Aadak9/TSEA56-Lagerrobot/readme.md

Använd respektive underkatalog för inlämning av olika dokument i projektet.

Underkatalogen statusrapport innehåller en fil statusrapport.md som ska uppdateras vid varje rapportering enligt instruktioner i filen.
