Aadak9/TSEA56-Lagerrobot/projektplan/Projektplan_vers1.2.pdf

Lagerrobot | 2025-03-09

# Projektplan

Grupp 6

2025-03-09

Version 1.2

Status

Granskad | Ebba Lundberg | 2025-03-09
Godkänd | Namn | 2025-xx-xx
TSEA56 | Kandidatprojekt i elektronik
Projektplan

Grupp 6

Lagerrobot | 2025-03-09

Beställare:
Mattias Krysander, Linköpings universitet Telefon: +46 13282198
E-post: mattias.krysander@liu.se

Handledare:
Theodor Lindberg, Linköpings universitet E-post: theodor.lindberg@liu.se

## Projektdeltagare

Namn | Ansvar | E-post
Linus Funquist | | linfu930@student.liu.se
Ebba Lundberg | Dokumentansvarig | ebblu474@student.liu.se
Andreas Nordström | Projektledare | andno773@student.liu.se
Sigge Rystedt | | sigry751@student.liu.se
Ida Sonesson | Dokumentansvarig | idaso956@student.liu.se
Lisa Ståhl | Designansvarig | lisst342@student.liu.se
TSEA56 | Kandidatprojekt i elektronik
Projektplan

Grupp 6

Lagerrobot | 2025-03-09

### I N N E H Å L L

1 Beställare | 1
2 Översiktlig beskrivning av projektet | 1
3 Organisationsplan för hela projektet | 1
4 Dokumentplan | 2
5 Utvecklingsmetodik | 2
6 Utbildningsplan | 2
7 Rapporteringsplan | 2
8 Mötesplan | 3
9 Resursplan | 3
10 Milstolpar och beslutspunkter | 4
11 Aktiviteter | 5
12 Tidplan | 5
13 Prioriteringar | 5
14 Projektavslut | 6
Referenser | 7
15 Appendix | 8
A | Tidplan | 8
TSEA56 | Kandidatprojekt i elektronik
Projektplan

Grupp 6

Lagerrobot | 2025-03-09

### D O K U M E N T H I S TO R I K

Version | Datum | Utförda ändringar | Utförda av | Granskad
0.1 | 2025-02-12 | Första utkast | EL, LS, IS, LF, SR, AN | EL, SR, LS, AN
1.0 | 2025-02-24 | Första version | EL, LS, IS, LF, SR, AN | AN
1.1 | 2025-03-03 | Första version med ändringar | EL, IS | EL
1.2 | 2025-03-09 | Första version med uppdate-
| | rad tidsplan | EL | EL
TSEA56 | Kandidatprojekt i elektronik
Projektplan

Grupp 6

Lagerrobot | 2025-03-09

### 1 B E S TÄ L L A R E

Beställare av projektet är Mattias Krysander på ISY, LiU.

### 2 ÖV E R S I K T L I G B E S K R I V N I N G AV P R O J E K T E T

Systemet ska designas så att en robot både kan styras manuellt via en dator och autonomt. Lagermiljön, som roboten ska kunna navigera, är känd för systemet och består av ett rutnät med hinder, plockstationer och en väg till utlämningsstationen. Roboten ska kunna börja vid utlämningsstationen, autonomt följa en linje till lagret med hjälp av sensorer och kunna hitta tillbaka med upplockade varor. I själva lagret ska den kunna undvika hinder och navigera till plockstationer där varorna ligger.

### 2.1 Syfte och mål

Projektets syfte är att konstruera ett system som konstruktionsalternativ till en lagerrobot, som med snabbhet och repeterbarhet kan utföra sitt uppdrag. Lagerroboten är en prototyp till en robot som ska tillverkas. Denna kommer prövas i en tävling för att utvärdera hur väl målen kring snabbhet och repeterbarhet är uppfyllda.

### 2.2 Leveranser

Leveranser och deras datum specificeras i kravspecifikationen sektion 11 [2].

### 2.3 Begränsningar

När lagermiljön och plockstationer är definierade i persondatorn och autonomt läge start, ska roboten klara sig själv. Undantaget är om robotarmen ska styras manuellt, vilket sker från persondatorn. Material som kan användas är endast det som ISY tillhandahåller. Projektgruppen har ett begränsat antal timmar att tillhandahålla, se avsnitt ekonomi.

### 3 O R G A N I S AT I O N S P L A N F Ö R H E L A P R O J E K T E T

Organisationsplanen kommer i huvudsak att följa LIPS-modellen som beskrivs i Projektmodellen LIPS [1]. Den följer en v-modell bestående av: krav, planering, design, implementation och test & verifiering med regelbunden återkoppling mellan stegen. Syftet är att hitta problem innan projektet har gått för långt och korrigeringar blir alltför tidskrävande.

### 3.1 Villkor för samarbetet inom projektgruppen

Se gruppkontrakt [3].

TSEA56 | Kandidatprojekt i elektronik
Projektplan | 1

Grupp 6

Lagerrobot | 2025-03-09

### 3.2 Definition av arbetsinnehåll och ansvar

Roll | Namn | Beskrivning
Styrenhetsansvarig | Linus Funquist | Delansvarig över styrenheten
Dokumentansvarig, kommuniaktionsansvarig | Ebba Lundberg | Övergripande ansvar för samtliga dokument samt kommunikationsenheten
Projektledare, Sensoransvarig | Andreas Nordström | Övergripande ansvar över projektet och delansvarig över sensorenheten
Sensoransvarig | Sigge Rystedt | Delansvarig över sensorenheten
Dokumentansvarig, kommunikationsansvarig | Ida Sonesson | Övergripande ansvar för samtliga dokument samt kommunikationsenheten
Styrenhetsansvarig, designansvarig | Lisa Ståhl | Delansvarig över styrenheten och systemdesign

### 4 D O K U M E N T P L A N

Se kravspecifikationen sektion 12 [2].

### 5 U T V E C K L I N G S M E TO D I K

För att säkerställa ett effektivt arbetsflöde kommer arbetet att delas upp baserat på expertis. Uppdelningen grundar sig bland annat på förstudier. När en uppgift är slutförd kommer den frigjorda tiden att användas för att stödja övriga gruppmedlemmar i deras arbete.

### 6 U T B I L D N I N G S P L A N

För att kunna genomföra projektet kommer det under projektets gång att behöva genomföras utbildningar i form av föreläsningar, laborationer, seminarier samt förstudier.

### 6.1 Egen utbildning

Den egna utbildningen kommer främst riktas mot kunskaper inom områden såsom reglerteknik, sensor och kommunikation för att möjliggöra förstudierna.

### 7 R A P P O R T E R I N G S P L A N

En veckorapport ska skickas in till beställare varje vecka. Denna inkluderar en tidsrapport och en statusrapport som besvarar följande frågor: - Vilka framsteg har gjorts sedan förra tidrapporten? - Finns det några problem? - Vad ska göras under den kommande veckan?
Veckorapporten ska skrivas av samtliga i gruppen under ett planerat möte varje måndag.
TSEA56 | Kandidatprojekt i elektronik
Projektplan | 2

Grupp 6

Lagerrobot | 2025-03-09

### 8 M ÖT E S P L A N

Under projektets gång kommer regelbundna möten genomföras en gång i veckan, med målet att gå igenom förra veckans arbete samt planera nästa vecka.

### 9 R E S U R S P L A N

Nedanstående punkter beskriver vilka olika typer av resurser gruppen har att tillgå.

### 9.1 Personer

Arbete förväntas av samtliga i gruppen utöver röda dagar, tentaperioder och planerade ledigheter. Planerad ledighet bör förvarnas om i god tid och berörd gruppmedlem bör kompensera denna frånvaro enligt överenskommelse inom gruppen.

### 9.2 Material

Materialet som kommer att användas tillgodoses av ISY och innefattar robotplattform, robotarm, mikrodatorer, sensorer, batterier samt motorer för reglering.

### 9.3 Lokaler

Projektgruppen kommer att ha tillgång till en laborationssal i Muxen samt Visionen där tester kommer att utföras.

### 9.4 Ekonomi

Gruppen har 230 timmar per person, totalt 1380 timmar för att lösa uppgiften. Dessa börjar räknas efter BP3.

TSEA56 | Kandidatprojekt i elektronik
Projektplan | 3

Grupp 6

Lagerrobot | 2025-03-09

### 10 M I L S TO L PA R O C H B E S L U T S P U N K T E R

Följande underrubriker beskriver projektets milstolpar och beslutspunkter samt när dessa infaller.

### 10.1 Milstolpar

Tabellen nedan visar samtliga milstolpar i projektet samt datumet då de infaller.

Nr | Beskrivning | Datum
0 | Designspecifikation 1.0 inlämnad | 12/3
1 | Förstudie inlämnad | 7/4
2 | Bussen klar | 10/4
3 | Manuell styrning | 25/4
4 | Manuell styrning av robotarm | 2/5
5 | Roboten kan följa tejpbit | 6/5
6 | Autonom körning | 13/5
7 | Fullständig GUI | 19/5
8 | Färdig presentation | 30/5
9 | Färdig rapport | 6/6

### 10.2 Beslutspunkter

Tabellen nedan visar samtliga beslutspunkter i projektet samt datumet då de infaller.

Nr | Beskrivning | Datum
0 | Projektgruppen formad och projektgrupp tilldelad | 24/1
1 | Kravspecifikationen v1.0 ska vara klar | 6/2
2 | Efter godkänd projektplan, tidplan och systemskiss hålls BP2 mötet med beställaren. | 24/2
3 | Designspecifikation godkänd | 12/3
4 | Nuvarande design godkänd av handledare | 17/4
5a | Färdigställandet av baskrav verifieras | 7/5
5b | Färdigställandet av slutkrav verifieras | 21/5
6 | Projektet avslutas | 9/6
TSEA56 | Kandidatprojekt i elektronik
Projektplan | 4

Grupp 6

Lagerrobot | 2025-03-09

### 11 A K T I V I T E T E R

Tabellen nedan visar samtliga aktiviteter i projektet, uppskattad tid och beroenden till andra aktiviteter.

Nr | Aktivitet | Beroende av aktivitet nr | Beräknad tid
1 | Skriva designspecifikation | | 80
2 | Kommunikation mellan PC och kommunikationsenheten | | 10
3 | Konstruera en fungerande buss mellan delsystemen | | 90
4 | Seriell överföring av data mellan PC och styrmodul | 2, 3 | 35
5 | Seriell överföring av data från sensormodul till PC | 2, 3, 7 | 30
6 | Fungerande kortaste väg algoritm med hinder | | 35
7 | Få alla sensorer att kunna läsa data | | 40
8 | Skriv kod för sensormodulen som gör om sensordata till läsbara storheter | | 60
9 | Spara sensordata på PC | 5 | 20
10 | Installera sensorenhet på robotplattform | | 20
11 | Få reflexsensorerna att registrera en tejpbit och lagerroboten kan stanna via en avbrottsrutin | 4, 5, 14 | 80
12 | Styrenheten kan skicka kommandon till styrmotorerna | | 40
13 | Skapa GUI som möjliggör testning | | 40
14 | Få robotplattformen att röra sig genom manuell styrning från PC | 4, 13, 18 | 60
15 | Kunna styra robotarmen manuellt | 4, 13 | 120
16 | Kunna plocka upp vara med robotarmen via fjärrstyrning | 15 | 60
17 | Skapa fullständig GUI för PC | 4, 9, 13 | 60
18 | Installera styr- och kommunikationsenhet på robotplattformen | | 50
19 | Få roboten att röra sig genom autonom styrning | 14 | 80
20 | Roboten kan åka till och från hämtningsstationen | 11, 19 | 70
21 | Skriva användarhandledning | | 30
22 | Skriva presentation | | 20
23 | Skriva efterstudie | | 15
24 | Skriva kappa | | 20
25 | Skriva teknisk dokumentation | | 60

### 12 T I D P L A N

Se Appendix A.

### 13 P R I O R I T E R I N G A R

Prioriteringar på projektet kommer att följa det som beskrevs i kravspecifikationen. Prioritet 1 krav kommer göras först följt av 2 och i mån av tid 3. Om nödvändigt kommer förseningar diskuteras med beställaren för omförhandling av kravspecifikationen.

TSEA56 | Kandidatprojekt i elektronik
Projektplan | 5

Grupp 6

Lagerrobot | 2025-03-09

### 14 P R O J E K TAV S L U T

Projektet avslutas den 9:e juni. Då ska:

- Efterstudien vara inlämnad
- Komplett och väldokumenterad källkod vara incheckad på git
- Komplett kandidatrapport vara inlämnad som en pdf-fil med all appendix inkluderade
- All utrustning och nycklar vara återlämnade
TSEA56 | Kandidatprojekt i elektronik
Projektplan | 6

Grupp 6

Lagerrobot | 2025-03-09

### R E F E R E N S E R

[1] Projektmodellen LIPS (2011), Tomas Svensson och Christian Krysander, uppl. 1:1, Studentlitteratur AB, Lund, ISBN 978-91-44-07525-9
[2] Kravspecifikation (2025), Grupp6: Kravspec_grupp6_version1.0.pdf
[3] Gruppkontrakt (2025), Grupp6: Gruppkontrakt_grupp6.pdf
TSEA56 | Kandidatprojekt i elektronik
Projektplan | 7

Grupp 6

Lagerrobot | 2025-03-09

### 15 A P P E N D I X

A | T I D P L A N
TSEA56 | Kandidatprojekt i elektronik
Projektplan | 8

Grupp 6

AKTIVITETER | TID | VEM | TIDPLAN (när), veckonummer
Nr | Beskrivning | timmar | Initialer | 1 | 2 | 3 | 4 | 5 | 6 | 7 | 8 | 9 | 10 | 11 | 12 | 13 | 14 | 15 | 16 | 17 | 18 | 19 | 20 | 21 | 22 | 23
| Kravspecifikation
| Tidsplan
| Gruppkontrakt
| Systemskiss
| Skrivuppgift
| Projektplan
72 | Alla | T | P | T | 0
el | E | Å | E | 0
N | S | N | 0
T | K | T | 0
240 | A | A | 0
P | P | 0

0
1 | 80 | Alla | 10 | 30 | 30 | 10 | 80

0
2 | 10 | el, is | 10 | 10
3 | 90 | el, is | 60 | 30 | 90
4 | 35 | el, is, ls, lf | 35 | 35
5 | 30 | el, is, an, sr | 30 | 30
6 | 35 | Alla | 35 | 35

0
7 | Få alla sensorer att kunna läsa data | 40 | an, sr | 40 | 40
8 | Skriv kod för sensormodulen som gör om sensordata till läsbara storheter | 60 | an, sr | 30 | 30 | 60
9 | Spara sensordata på PC | 20 | an, sr | 20 | 20
10 | Installera sensorenhet på robotplattform | 20 | an, sr | 20 | 20
11 | Få reflexsensorerna att registrera en tejpbit och lagerroboten kan stanna via en avbrottsrutin | 80 | an, sr | 60 | 20 | 80
Styrenhet | 0
12 | Styrenheten kan skicka kommandon till styrmotorerna | 40 | ls, lf | 40 | 40
PC | 0
13 | Skapa GUI som möjliggör testning | 40 | Alla | 10 | 30 | 40
14 | Få robotplattformen att röra sig genom manuell styrning från PC | 60 | Alla | 60 | 60
15 | Kunna styra robotarmen manuellt | 120 | Alla | 60 | 60 | 120
16 | Kunna plocka upp vara med robotarmen via fjärrstyrning | 60 | Alla | 40 | 20 | 60
17 | Skapa fullständig GUI för PC | 60 | Alla | 40 | 20 | 60

0
18 | Installera styr- och kommunikationsenhet på robotplattformen | 50 | Alla | 50 | 50
19 | Få roboten att röra sig genom autonom styrning | 80 | Alla | 80 | 80
20 | Roboten kan åka till och från hämtningsstationen | 70 | Alla | 40 | 30 | 70
Dokumentation | 0
21 | Användarhandledning | 30 | Alla | 20 | 10 | 30
22 | Presentation | 20 | Alla | 20 | 20
23 | Efterstudie | 15 | Alla | 15 | 15
24 | Kappa | 20 | Alla | 20 | 20
25 | Teknisk dokumentation | 60 | Alla | 10 | 50 | 60
Övrigt | 0
Buffert | 135 | 13 | 13 | 13 | 13 | 13 | 14 | 14 | 14 | 14 | 14 | 135
Projektmöten | 40 | Alla | 4 | 4 | 4 | 4 | 4 | 4 | 4 | 4 | 4 | 4 | 40
Milstolpar | 0
0 | Designspecifikation 1.0 inlämnad | on | 0
1 | Förstudie inlämnad | må | 0
2 | Bussen klar | to | 0
3 | Manuell styrning | fre | 0
4 | Manuell styrning av robotarm | fre | 0
5 | Roboten kan följa tejpbit | ti | 0
6 | Autonom körning | ti | 0
7 | Fullständig GUI | må | 0
8 | Färdig presentation | fr | 0
9 | Färdig rapport | fr | 0

0
0
Beslutspunkter | 0
BP 1 | to | 0
BP 2 | må | 0
BP 3 | on | 0
BP 4 | to | 0
BP 5a | on | 0
BP 5b | on | 0
BP 6 | må | 0

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
1380 | 0 | 0 | 0 | 0 | 0 | 0 | 0 | 10 | 30 | 30 | 10 | 0 | 10 | 227 | 212 | 37 | 177 | 157 | 198 | 133 | 133 | 18 | 18 | ###

Basplan
Projekt:
Datum:
Ebba Lundberg, 2025-03-09
Projektgrupp: | Granskad:
| Mattias Krysander
Kurs: | TSEA56

Summa antal timmar:

Beställare:

Designspecifikation
Kommunikationsenhet
Kommunikation mellan PC och kommunikationsenheten Konstruera en fungerande buss mellan delsystemen Seriell överföring av data mellan PC och styrmodul Seriell överföring av data från sensormodul till PC Fungerande kortaste väg algoritm med hinder Sensorenhet

3/9/2025
1.2
Ebba Lundberg

Version:
Utfärdare:

G06
