Aadak9/TSEA56-Lagerrobot/RaspberryPi/main2.py

import spi as spi
import bluetooth as bt
import autonom as auto
import time
import threading
from collections import deque
import handle_map as hm
import json
import fastest_way3 as fw

global next_move
next_move = None
global new_plan
new_plan = False
global goal_collected
goal_collected = False
global nodeorder
nodeorder = []
size = 1024

has_seen_roadmark = False
global obstacles
obstacles = []
global goods_deposited
goods_deposited = False

def autonomous_loop(spi_styr, spi_sensor, KP, KD):
	global nav_plan
	global new_plan
	global goal_collected
	global has_seen_roadmark
	global nodeorder
	global obstacles
	global goods_deposited
	try:
		next_move = nav_plan[0]
	except:
		return
	roadmark_status = auto.check_roadmark(spi_sensor)
	målnoder = hm.get_målnoder()

	
	if(auto.check_obstacle(spi_sensor)):
		spi.send_spi(spi_styr, 0) #stanna
        
		current_node, next_node = fw.find_location(nav_plan, nodeorder) #current_node = den noden man åker tillbaka till efter påkommet hinder, next_node = den man inte kom till 
		obstacles.append([current_node, next_node])
		målnoder[1] = [current_node]
		nav_plan, nodeorder = hm.update_path_obstacles(obstacles, målnoder) #måste komma åt målnoder på nåt sätt        
		new_plan = True
		auto.rotate_right_180(spi_styr, spi_sensor)
        
	if(roadmark_status == 0):
		has_seen_roadmark = False
		auto.control_loop(spi_styr, spi_sensor, KP, KD)
		
	elif(roadmark_status == 1): # dags att plocka vara åt höger
		if(next_move == "plocka"):
			goal_collected = True
			spi.send_spi(spi_styr, 0) #stanna och plocka vara
			auto.pick_right(spi_styr)
			current_node, next_node = fw.find_location(nav_plan, nodeorder) 
			hm.remove_goal_node(current_node, next_node)
			next_move = nav_plan.popleft()
			if(nav_plan[0] == "vänd"):
				auto.rotate_right_180(spi_styr, spi_sensor)
				nav_plan.popleft()
		else:
			auto.drive_fwd(spi_styr) # Kör förbi plockstaion
			
	elif(roadmark_status == 2): # dags att plocka vara åt vänster
		if(next_move == "plocka"):
			goal_collected = True 
			spi.send_spi(spi_styr, 0) #stanna och plocka vara
			auto.pick_left(spi_styr)
			current_node, next_node = fw.find_location(nav_plan, nodeorder) 
			hm.remove_goal_node(current_node, next_node)
			next_move = nav_plan.popleft()
			if(nav_plan[0] == "vänd"):
				auto.rotate_right_180(spi_styr, spi_sensor)
				nav_plan.popleft()
		else:
			auto.drive_fwd(spi_styr) # Kör förbi plockstaion
			
	elif(roadmark_status == 3 and not has_seen_roadmark): #sväng utifrån planerad väg
		has_seen_roadmark = True
		time.sleep(0.08)
		if(nav_plan):
			next_move = nav_plan.popleft()
		else:
			print("Slut på styrbeslut")
		#Kolla om vi ska svänga eller ej
        
		if(next_move == "rakt"):
			auto.drive_fwd(spi_styr)
		elif(next_move == "vänster"):
			auto.rotate_left(spi_styr, spi_sensor)  
		elif(next_move == "höger"):
			auto.rotate_right(spi_styr, spi_sensor)
		elif(next_move == "lämna"):
			spi.send_spi(spi_styr, 0)
			auto.empty_basket3(spi_styr)
			goods_deposited = True
			
	else:
		auto.drive_fwd(spi_styr)
       

def bluetooth_control_loop(data, client, spi_styr, spi_sensor):
	global new_plan
	global nav_plan
	global målnoder
	global goal_collected
	global goods_deposited
	try:
		if(data == "20"): #Ändrar aktuell armled
			data = client.recv(size) 
			try:
				spi.send_spi(spi_styr, [0x20] + list(data))
			except:
				print("Invalid data 1")
                
		elif data == "60": #IR
			response = spi.send_spi(spi_sensor, 0)
			client.send(response.to_bytes(1, 'big'))		
		elif data == "61": #Reflex
			response = spi.send_spi(spi_sensor, 1)
			client.send(response.to_bytes(1, 'big'))	
		elif data == "67": #kalibrera linjesensor
			spi.send_spi(spi_sensor, 7)
			time.sleep(0.01)
			
		elif data == "63": #Starta gyro
			spi.send_spi(spi_sensor, 3)
			time.sleep(0.01)
		elif data == "62": #Gyro
			response = spi.send_spi(spi_sensor, 5)
			client.send(response.to_bytes(1, 'big'))
		elif data == "64": #Stoppa gyro
			spi.send_spi(spi_sensor, 4)
			time.sleep(0.01)
			
		elif data == "65": #gaspådrag höger
			response = spi.send_spi(spi_styr, 0x41)
			client.send(response.to_bytes(1, 'big'))
		elif data == "66": #gaspådrag vänster
			response = spi.send_spi(spi_styr, 0x40)
			client.send(response.to_bytes(1, 'big'))
            
		elif data == "80": #skicka styrbeslut
			if new_plan:
				client.send(b'\x01')
				hm.send_map(nav_plan, client)
				new_plan = False
			else:
				client.send(b'\x00')
		elif data == "81": #upplockade varor
			if goal_collected:
				client.send(b'\x01')
				goal_collected = False
			else:
				client.send(b'\x00')
				
		elif data == "82": #avbryta autonomt läge i gui
			if goods_deposited:
				client.send(b'\x01')
				goods_deposited = False
			else:
				client.send(b'\x00')
        
		else:
			try:
				response = spi.send_spi(spi_styr, int(data, 16))	
			except:
				print("Invalid data 2")
	except:
		print("Disconnected, looking for new socket")            


def bluetooth_listener(s, spi_styr, spi_sensor):
	global new_plan
	global nav_plan
	global nodeorder
	global goods_deposited
	global obstacles
	client, _ = s.accept()
	print("Bluetooth connected")
	while True:
		try:
			data = client.recv(1).hex()
			if data == "99": #Växla körläge
				if auto.Automatic:
					spi.send_spi(spi_styr, 0)
				else:
					nav_plan, nodeorder = hm.update_path(client) #tagit bort att den ska ta emot nodeorder
					new_plan = True  
					goods_deposited = False
					obstacles = []
				auto.Automatic = not auto.Automatic
				continue
			else:
				bluetooth_control_loop(data, client, spi_styr, spi_sensor)
		except Exception as e:
			print(f"Bluetooth error: {e}")
			try:
				client.close()
			except:
				pass
			print("Waiting for connection...")
			client, _ = s.accept()
			print("Connected!")


def main():
	global nav_plan
	nav_plan = 0
	s = bt.init_bluetooth()
	spi_styr, spi_sensor = spi.initspi()

	bt_thread = threading.Thread(target=bluetooth_listener, args=(s, spi_styr, spi_sensor), daemon=True)
	bt_thread.start()

	KP, KD = 100, 100

	while True:
		old_Automatic = auto.Automatic
		if auto.Automatic:
			autonomous_loop(spi_styr, spi_sensor, KP, KD)
			time.sleep(0.005)
		if(old_Automatic == True and auto.Automatic == False):
			spi.send_spi(spi_styr, 0)
        

if __name__ == "__main__":
    main()
