Aadak9/TSEA56-Lagerrobot/Styr/Styrenhet/Styrenhet/Kommunikations_Definitioner.h

#define DRIVE_FWD 0x1

#define ROTATE_LEFT 0x2

#define REVERSE 0x3

#define ROTATE_RIGHT 0x4

#define FWD_LEFT 0x5

#define FWD_RIGHT 0x6

#define STOP 0

#define DECREASE_SPEED 0x14

#define INCREASE_SPEED 0x15

#define SET_JOINT 0x20

#define FOLLOW_LINE 0x30

#define CCW_SERVO 0x31

#define CW_servo 0x32

#define SEND_LEFT_GAS 0x40

#define SEND_RIGHT_GAS 0x41

#define SEND_ANGLE 0x50

#define MOVE_SERVO 0x60
