Aadak9/TSEA56-Lagerrobot/RaspberryPi/fastest_way3.py

from collections import deque
import itertools
#Får lagerbredd, lagerhöjd, koordinater för målnod från PC


def skapa_graf(lagerbredd, lagerhöjd):
	#skapar dictionary med alla grannar nedåt och till höger för alla noder i lagret
	graf = {}
	ny = lagerbredd + 1
	nx = lagerhöjd + 1
	for y in range(ny):
		for x in range(nx):
			node = y * nx + x + 1
			graf[node] = []
			# höger granne
			if x < nx - 1:
				graf[node].append(node + 1)
			# nedåt granne
			if y < ny - 1:
				graf[node].append(node + nx)
			# vänster granne
			if x > 0:
				graf[node].append(node - 1)
			# övre granne
			if y > 0:
				graf[node].append(node-nx)
	return graf


def bfs(graf, startnod, målnod, next_node, last_node):    
	# Beräknar korstaste vägen mellan två ndoer
	paths = [] 
	for i  in range(len(startnod)):
		queue = deque([[startnod[i]]])
		visited = set()
		while queue:
			path = queue.popleft()
			node = path[-1]
			if node in visited:
				continue
			visited.add(node)
			for neighbor in graf[node]:
				new_path = path + [neighbor]
				if [node, neighbor] == målnod or [neighbor, node] == målnod or [neighbor] == målnod:
					paths.append(new_path + ['goal'])
				queue.append(new_path)
	if last_node == 0:
		return min(paths, key=len)
	if len(målnod) == 1 and målnod[0] in startnod and last_node != 1: #om varan ligger jämte nod 1 och inte kommer från nod 1 ...
		for i in startnod:
			if [i] != målnod:
				return [målnod[0], 'goal'] #.... ska den åka ut
	
	shortest_dist = min(len(l) for l in paths)
	shortest_paths = [l for l in paths if len(l) == shortest_dist]
	check = False
	# Om två vägar är lika lång och en kräver vändning så välj den som inte vänder
	for i in range(len(shortest_paths)-1):
		if len(shortest_paths) > 1 and shortest_paths[i][0] != shortest_paths[i+1][0]:
			check = True
	if check:
		for j in shortest_paths[:]:
			if j[0] != next_node:
				shortest_paths.remove(j)
	shortest = min(shortest_paths, key=len)
	if shortest[0] != next_node:
		shortest = [next_node] + shortest
	
	return shortest

    
def skapa_avståndsmatris(graf, nodes):
	#Skapar avståndsmatris med längden mellan varje par noder
	ant_noder  = len(nodes) 
	matris = [[0]*ant_noder for _ in range(ant_noder)]
	for i in range(ant_noder):
		for j in range(ant_noder):
			if i != j:
				path = bfs(graf, nodes[i+1], nodes[j+1], 0, 0)
				if i == 0:
					matris[i][j] = len(path) - 2 if path else float('infinity')
				else:
					matris[i][j] = len(path) - 1 if path else float('infinity')

	return matris
 
 
def held_karp_väg(matris):
	# Beräknar kortaste vägen från start, genom alla målnoder och till slut samt kostnaden för den vägen
	n = len(matris)
	dp = [[float('inf')] * n for _ in range(1 << n)]
	parent = [[-1] * n for _ in range(1 << n)]
	dp[1][0] = 0  # Startar i nod 0

	for mask in range(1 << n):
		for u in range(n):
			if not (mask & (1 << u)):
				continue
			for v in range(n):
				if mask & (1 << v):
					continue
				next_mask = mask | (1 << v)
				new_cost = dp[mask][u] + matris[u][v]
				if new_cost < dp[next_mask][v]:
					dp[next_mask][v] = new_cost
					parent[next_mask][v] = u

	# Hitta bästa retur till start
	slutkostnad = float('inf')
	sista_nod = -1
	full_mask = (1 << n) - 1
	for i in range(1, n):
		cost = dp[full_mask][i] + matris[i][0]
		if cost < slutkostnad:
			slutkostnad = cost
			sista_nod = i

	# Återskapa vägen baklänges
	path = [0]
	mask = full_mask
	current = sista_nod
	while current != -1:
		path.append(current)
		prev = parent[mask][current]
		mask = mask ^ (1 << current)
		current = prev

	path = list(reversed(path))
	return slutkostnad, path


def node_to_xy(node, lagerbredd, lagerhöjd):
	#Tilldelar koordinater till noden
	nx = lagerbredd + 1
	ny = lagerhöjd + 1
	for i in range(0, nx):
		for j in range(0, ny):
			if node == j + ny * i + 1:
				return(i, j)
			else:
				continue
    
	return(0,0)
            

def get_direction(p1, p2):
	#Beräknar differans i koordinater mellan två noder
	return (p2[0] - p1[0], p2[1] - p1[1])


def direction_to_angle(direction):
	# Gör om (dx, dy) till en riktning i grader
	if direction == (0, 1):
		return 0    # nedåt
	elif direction == (1, 0):
		return 90   # höger
	elif direction == (0, -1):
		return 180  # uppåt
	elif direction == (-1, 0):
		return 270  # vänster
	else:
		return None # ogiltig


def sväng_instructions(correct_path, lagerbredd, lagerhöjd):
	# Omvanlar nodföljden till styrbeslut
	directions = []
	# Ta bort 'goal'
	pos = [node_to_xy(n, lagerbredd, lagerhöjd) for n in correct_path if isinstance(n, int)]
	if len(pos) < 2:
		return directions

	# Initial riktning. Kommer alltid "uppifrån" in i nod 1
	prev_angle = 0
    
	for i in range(0, len(correct_path)-1):
		
		if correct_path[i] == 'goal':
			directions.append("plocka")
		
		elif correct_path[i] != 'goal' and correct_path[i+1] != 'goal': 
			curr = node_to_xy(correct_path[i], lagerbredd, lagerhöjd)
			next_n = node_to_xy(correct_path[i+1], lagerbredd, lagerhöjd)
			current_dir = get_direction(curr, next_n)
			current_angle = direction_to_angle(current_dir)
			
			delta = (current_angle - prev_angle) % 360
			#print("delta " + str(delta))
			if delta == 0:
				directions.append("rakt")  # rakt fram
			elif delta == 90:
				directions.append("vänster")  # höger
			elif delta == 270:
				directions.append("höger")  # vänster
			elif delta == 180:
				directions.append("vänd")  # vändning
			else:
				directions.append("vänd")  # vändning

			prev_angle = current_angle
    
	if current_angle == 270:
		directions.append("höger")
	elif current_angle == 180:
		directions.append("rakt")

	return directions


def remove_path(Graf, n1, n2):
	#Ta bort n1 från n2´s grannar och n2 från n1´s grannar
	for i in Graf:
		if i == n1:
			Graf[i].remove(n2)
		elif i == n2:
			Graf[i].remove(n1)
    
	return(Graf)
            

def fastest_way(lagerbredd, lagerhöjd, målnoder):
	#Beräknar kortaste vägen
	Graf = skapa_graf(lagerbredd, lagerhöjd)
	matris = skapa_avståndsmatris(Graf, målnoder)
	kostnad, ordning = held_karp_väg(matris)
	key = list(målnoder)[-1]
	if målnoder[key] != [1]:
		målnoder[len(målnoder)+1] = [1] #ska alltid avsluta i nod 1

	path = []
	#beräkna vägen till alla varor
	for i in range(len(ordning)-1):
		if len(path) > 0: 
			last_path = path[i-1]
			path.append(bfs(Graf, målnoder[ordning[i] + 1], målnoder[ordning[i+1] + 1], last_path[-2], last_path[-3]))
		else:
			path.append(bfs(Graf, målnoder[ordning[i] + 1], målnoder[ordning[i+1] + 1], 0, 0))

	correct_path = [item for sublist in path for item in sublist]
	nodeorder = []
	
	for i in correct_path:
		if isinstance(i,int):
			nodeorder.append(i)
		
	väg = deque(sväng_instructions(correct_path, lagerbredd, lagerhöjd))
	if väg[-1] != "lämna":
		väg.append("lämna")
	
	return väg, nodeorder, correct_path


def find_location(path, nodeorder): 
	#Beräknar vilka noder roboten är mellan
	diff = len(nodeorder) - len(path)
	current_node = nodeorder[diff]
	next_node = nodeorder[diff + 1]
	new_nodeorder = nodeorder[diff:]
	
	return current_node, next_node
