Aadak9/TSEA56-Lagerrobot/(commit log)

2025-04-01 Upload New File
    [Tidsplan_v14.xlsx.xlsx]
2025-04-01 Testfil i Sensor
2025-04-01 Tog bort timmarna ner till aktivitet designspecifikation.
    [Tidsplan_v14_2.xlsx]
2025-04-02 Grundläggande servostyrning
2025-04-07 Snyggat till servo och motorkod
2025-04-08 Fixade read_reflex() och la till init_gryo()
    [convert.c, convert.h, init.c, main.c]
2025-04-09 Fortsätt jobba på gyrot. Alla funktioner returnerar nu rätt formatterad utdata. Lagt till interrupt för SPI-bussen.
2025-04-10 Avstånd samt linjesensor funkar helt, påbörjat gyrot
2025-04-11 SPI fixat för manuell styrning, försöker lösa manuellservostyrning
    [Motorcontrol.h, SPI.h, Servocontrol.h, init.h, main.c]
2025-04-11 grundläggande gui med bluetooth till raspberry
2025-04-11 Gyrot fungerar isch
2025-04-14 Tagit bort avbrott för gyro. Sensormodulen i stort sett klar
2025-04-15 uppdaterat gui för sensordata
2025-04-16 fixat så vi kan skicka data mellan pc och raspberry, grunden
2025-04-16 Jobbat på SPI-buss
2025-04-16 SPI-buss för sensor
2025-04-16 Fixade avståndstabell istället manuell beräkning
    [convert.c, convert.h, read.c]
2025-04-16 Lite pill med gyrotabell
2025-04-22 fixat så sensordata uppdateras i gui
2025-04-23 Kringgår ett problem med tejpsensorn. Typecastar nu istället för att använda convert_uint8_t()
    [convert.c, init.c, read.c]
2025-04-23 Gyroskopet borde funka. Tagit bort mög
2025-04-25 småpfix med manuellt servostyr
2025-04-25 Försökt med vinkel från gyro till derivatadel i regleringen. Data kan skickas men blir jättefel
2025-04-25 Jobbat mer med servostyrning, börjat på att styra servopar så att armen inte sprängs
2025-04-28 Fixat så att armen förhoppningsvis kan användas utan att sprängas (mata in vilken led man styr så styrs relevanta servon)
    [Servocontrol.h, main.c]
2025-04-28 Linjesensor bak fungar inte, sitter snett. Gyrot återställt till gammal kod.
2025-04-28 skapat nya filer för att spara data i en csv fil samt lite ändringar i bluetooth och interface
    [data.csv]
2025-04-29 utvecklat git med starta data knapp i manuell
    [data.csv]
2025-05-02 ändringar fö gyro
2025-05-02 ändringar i interface
    [data.csv]
2025-05-02 fixat så data uppdateras i guin
    [data.csv]
2025-05-05 Gyrot funkar gott folk, inte linjesensorn
2025-05-06 Fixat mindre fel i bakre linjesensorn
    [main.c, read.c]
2025-05-07 nytt GUI upplägg, lite knas men funkar typ nu
    [data.csv]
2025-05-08 gjortom koden för lager och fixat så man kan skicka noderna till raspberryn
2025-05-12 fixat kortastevägen för inte kvadrater
    [fastest_way3.py]
2025-05-12 fixat så vi kan se styrbeslut i gui
    [bluetooth.py]
2025-05-15 Ändrat småsaker i Raspberry samt lagt till arm saker
2025-05-16 snabbare servon
2025-05-20 spara och plotta data efter körning
    [Sparad_data.csv]
2025-05-20 data kan sparas och plottas
    [Sparad_data.csv]
2025-05-20 tagit bort startdata knappen och ändrat i savedata då jag inte fick permission
    [Sparad_data.csv]
2025-05-20 fixat så att vi ser i vilken ordning varorna hämtas
    [Sparad_data.csv]
2025-05-20 fixat bugg i fastest way
    [autonom.py, fastest_way3.py, handle_map.py, main2.py]
2025-05-20 fixat så upplockade varor rensas efter en körning
    [Sparad_data.csv]
2025-05-21 sista med buggar i kortaste väg
    [autonom.py, fastest_way3.py, fastest_way_hinder.py, handle_map.py, main2.py]
2025-05-21 Användarhandledning och teknisk dokumentation uppladdad
    [Sparad_data.csv]
2025-06-06 Rensat lite gamla filer från git
    [Sparad_data.csv, data.csv]
2025-06-10 Tagit bort vissa mappar
    [Tidsplan_v13.xlsx, Tidsplan_v14.xlsx, Tidsplan_v15.xlsx, Tidsplan_v16.xlsx, Tidsplan_v17.xlsx, Tidsplan_v18.xlsx, Tidsplan_v19.xlsx, Tidsplan_v20.xlsx]
